kimitobo/motococo/pics/IMG_1678.JPG

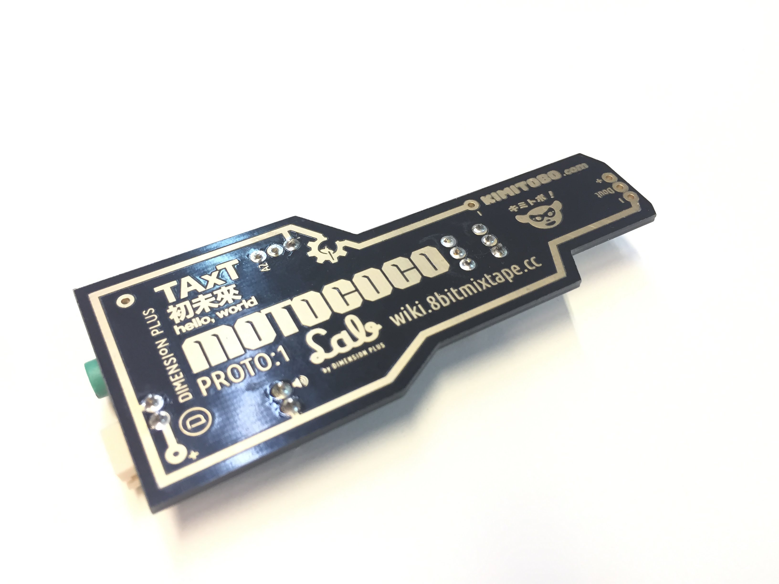
pics/IMG_1678.JPG
