kimitobo/motococo/pics/IMG_1687.JPG

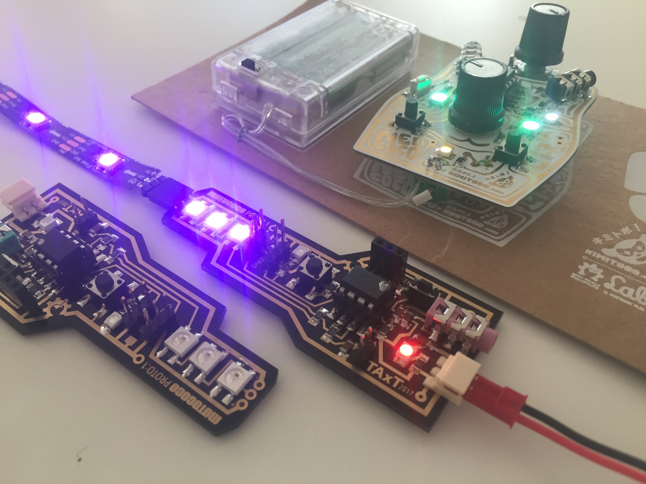
pics/IMG_1687.JPG
