kimitobo/motococo/guides/Motococo_schematic_v01.pdf

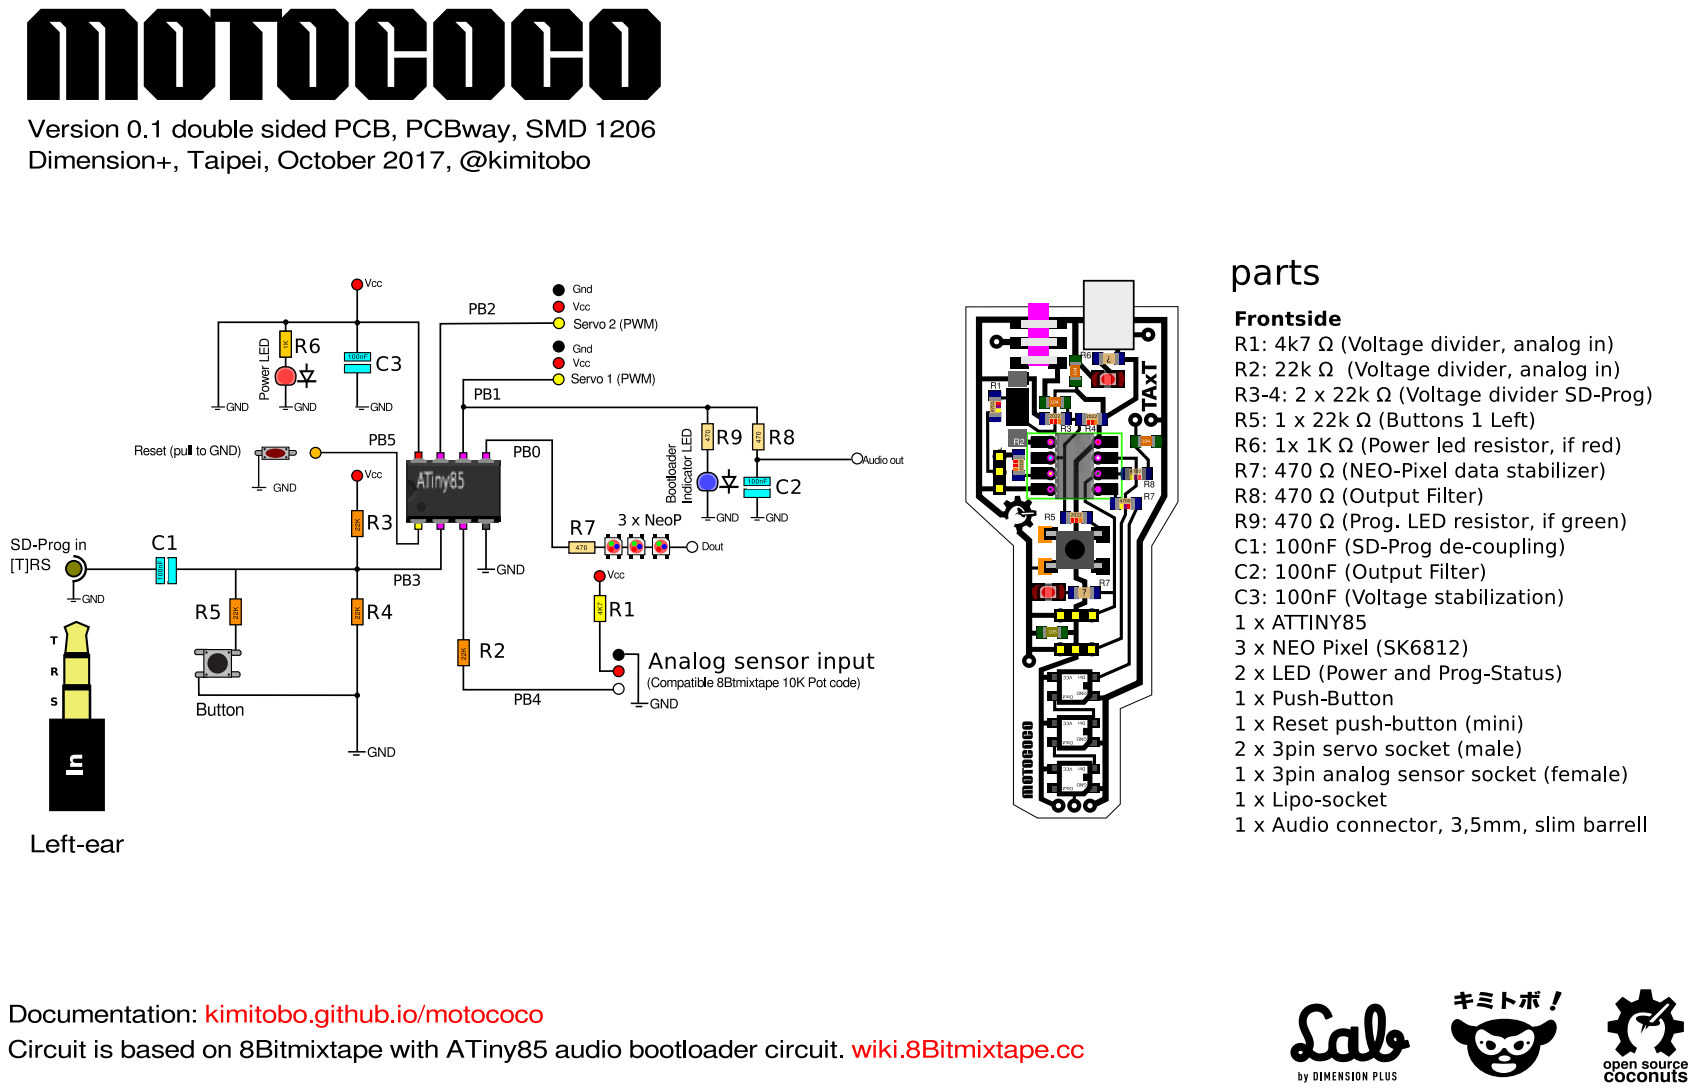
[picture p4: page 1]
